nebisman/UNDCMotor/docs/WorkingDiagramMotorDC.png

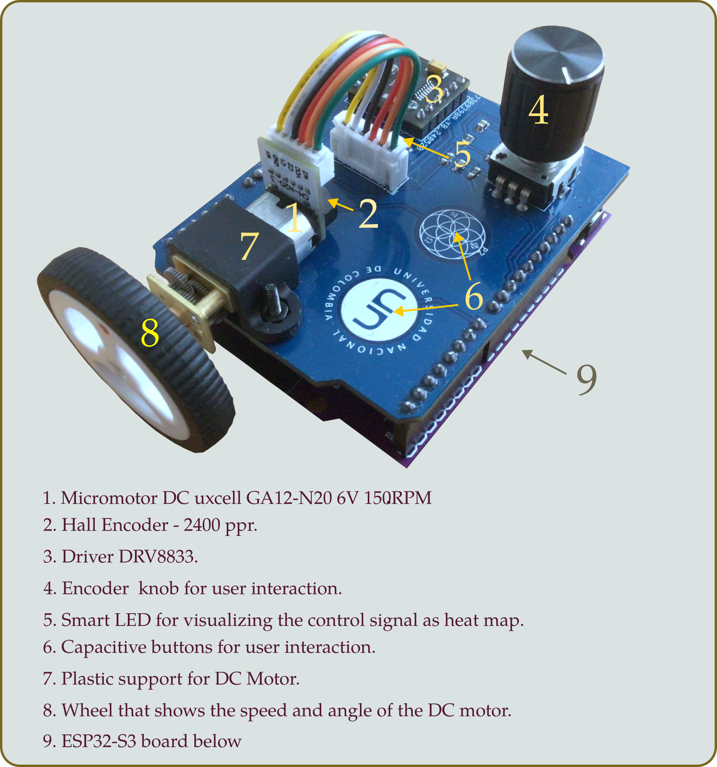
docs/WorkingDiagramMotorDC.png
