nebisman/UNDCMotor/README.md

# DCmotorSystem_IoT
This is the control of a DC motor through IoT
