nebisman/UNDCMotor/docs/modelo_matematico_unmotor.pdf

56 | Capítulo 4. Control IOT de las plantas físicas

### 4.1 Modelo matemático del UNDCMotor

| La figura 4.1 muestra el modelo electromecánico lineal de un motor DC como el usado
en el UNDCMotor. Aunque este modelo no considera efectos no lineales como la zona muerta, la fricción estática y el juego mecánico, es suficiente para el diseño de sistemas de control de movimiento [5]. Los efectos no lineales son compensados por aparte.

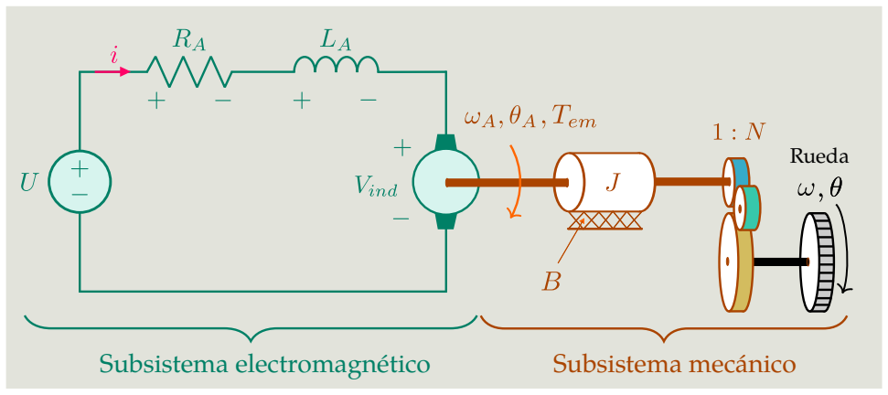
[picture p2: figure]
Subsistema electromagnético; Subsistema mecánico; Rueda

Figura 4.1: Modelo electromecánico del motor DC.

La figura 4.1 nos muestra que el motor DC puede ser descompuesto claramente en dos subsistemas: el subsistema electromagnético (verde) y el subsistema mecánico (café).

Subsistema electromagnético. Consideremos el circuito ilustrado en verde en la figura 4.1. Las variables y parámetros de este circuito se definen así:

u(t) : Tensión de entrada (V). vind(t) : Fuerza contraelectromotriz (V). i(t) : Corriente de armadura (A).
RA : Resistencia de armadura (Ω). LA : Inductancia de armadura (H).

Al aplicar la ley de tensiones de Kirchoff, obtenemos la siguiente ecuación:

u(t)−iRA −LA

di
dt
−vind(t) = 0. | (4.1)

Subsistema mecánico. Consideremos el subsistema mecánico ilustrado café en la figu-

4.1 Modelo matemático del UNDCMotor | 57

ra 4.1. Las variables y parámetros de este sistema son:

ωA : Velocidad angular del rotor (rad/s).
θA : Desplazamiento angular del rotor (rad).
ω : Velocidad angular de salida (después del reductor) (rad/s).
θ : Desplazamiento angular de salida (después del reductor) (rad). τem : Torque electromagnético generado.
J : Momento de inercia del motor (N·m).
B : Constante de fricción viscosa del motor (A).
N : Relación de engranajes del reductor (adimensional).

Al aplicar las leyes de Newton, obtenemos la siguiente ecuación:

τem −J

ωA
dt
−BωA = 0 | (4.2)

Comentario 4.1.1 — ¿Qué pasa con la inercia de la rueda?. Note que el modelo del motor DC presentado en la figura 4.1 y desarrollado en las ecuaciones
(4.1) y (4.2) asume que el momento de inercia de la rueda es despreciable. Vamos a examinar el por qué. Denotando por Mc a la masa de la rueda y por R a su radio, tenemos que el momento de inercia de la rueda está dado por:

JC =

1
2

MC R

2
. | (4.3)

Asimismo, el momento de inercia total del sistema, visto desde el rotor es:

Jeq = J +

JC
N²
. | (4.4)

La ecuación (4.3) implica que el momento de inercia Jc tiene un valor pequeño, dado que la masa Mc de la rueda es de algunos gramos. Adicionalmente, cuando
ese pequeño valor se refleja en el rotor, aparece dividido por el factor N | 2 = 10000
(véase la tabla 2.3), de acuerdo con la ecuación (4.4). De esto, concluimos que el momento de inercia de la rueda es despreciable, esto es:

Jeq ' J.

Un análisis similar nos lleva a que la fricción viscosa de la rueda también es despreciable.

Ecuaciones algebraicas: La relación entre los dominios electromagnético y mecánico está dada por la siguientes ecuaciones:

τem = µ i, | (4.5)
Vind = µ ωA, | (4.6)
ω = ωA/N. | (4.7)

58 | Capítulo 4. Control IOT de las plantas físicas

La ecuación (4.5) y la ecuación (4.6) se desprenden, respectivamente, de la ecuación de fuerza de Lorentz y de la ley de Faraday¹
. La ecuación (4.7) es la relación del reductor de engranajes del motor.

Modelo en espacio de estados: La salida de interés de nuestro sistema es la velocidad angular ω (o del dezplazamiento angular θ) después del reductor. Combinando y organizando las ecuaciones (4.1), (4.2), (4.5) y (4.6), obtenemos la siguiente representación de estado del motor DC:

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
J N −

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
u(t),

y =

h

0 1i

i

ω

+0 · u(t).

(4.8)

La descripción de estado de la ecuación (4.8) nos permite obtener la función de transferencia del motor a partir de la siguiente ecuación [4]:

G(s) = C(sI −A)

−1B+d | (4.9)

Resultado 4.1.2 — Función de transferencia del motor D.C en velocidad. Usando la ecuación (4.9) con

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
J N −

B
J N
, B =

1
LA
0
, C =

h

0 1i
, D = 0,

obtenemos la siguiente función de transferencia que relaciona la entrada U(s) (tensión en el dominio de Laplace) con Y(s) (velocidad angular en el dominio de Laplace):

Y(s)
U(s)

=

µ
J LAN s² + (BLA +J N RA) s+ µ

2 +BRA

(4.10)

En aplicaciones típicas, incluido el UNDCmotor, es usual considerar que la inductancia del susbsistema eléctrico es despreciable (esto es, LA = 0), con lo cual tendremos el siguiente modelo simplificado:

Y(s)
U(s)

=

α
τ s+1
. | (4.11)

1Para una explicación física detallada, remitimos al lector al excelente libro de Chiasson [5].

4.2 Identificación del UNDCMotor | 59

En que α y τ se definen como:

α =

µ

µ

2 +BRA

,

τ =

J N RA

µ

2 +BRA

Resultado 4.1.3 — Función de transferencia en desplazamiento angular. Deno-temos por Yθ (s) al desplazamiento angular en el dominio de Laplace. Puesto que la velocidad angular es la derivada del desplazamiento angular, tenemos que:

Y(s) = sYθ (s). | (4.12)

Substituyendo Yθ (s) de la ecuación (4.12) en la ecuación (4.10), obtenemos la función de transferencia entre la tensión y el desplazamiento angular Yθ (s):

Ω(s)
U(s)

=

µ
s( J LAN s² + (BLA +J N RA) s+ µ

2 +BRA )

. | (4.13)

Asimismo, usando la ecuación (4.11) podemos obtener una función de transferencia simplificada, dada por:
Yθ (s)
U(s)

=

α
s(τ s+1)
. | (4.14)

### 4.2 Identificación del UNDCMotor

### 4.2.1 Modelo estático

Es natural comenzar investigando el comportamiento estacionario de un sistema bajo control. Esto se hace mediante una curva que muestra el valor en estado estacionario de la salida (en este caso, la velocidad del motor DC) para diferentes valores de la variable de entrada (en este caso la tensión aplicada). A esta curva se le denomina Modelo Estático del Sistema [1].
El modelo estático se puede obtener experimentalmente de varias formas. Una manera habitual es ajustar un valor constante de entrada y medir la salida en estado estacionario. Esto da un punto del modelo estático. Este procedimiento se repite para cubrir todo el rango de entradas.
El siguiente código permite obtener directamente el modelo estático del UNDCMotor:

1 motor1 = MotorSystemIoT ()
2 get_static_model ( motor1 )

Como resultado de aplicar está función se despliega la figura 4.2.

Comentario 4.2.1 — Ganancia estática del sistema. La pendiente de la curva de la figura4.2 nos dice cuánto cambia la velocidad para pequeños cambios en la tensión de entrada. Grandes variaciones en la ganancia indican que el problema de control puede ser difícil. Por ejemplo, observamos que el UNDCMotores difícil de controlar para
