nebisman/UNDCMotor/SchematicLayout/DCmotorCircuit.kicad_pcb

## KiCad design SchematicLayout/DCmotorCircuit.kicad_pcb (2024-05-27)

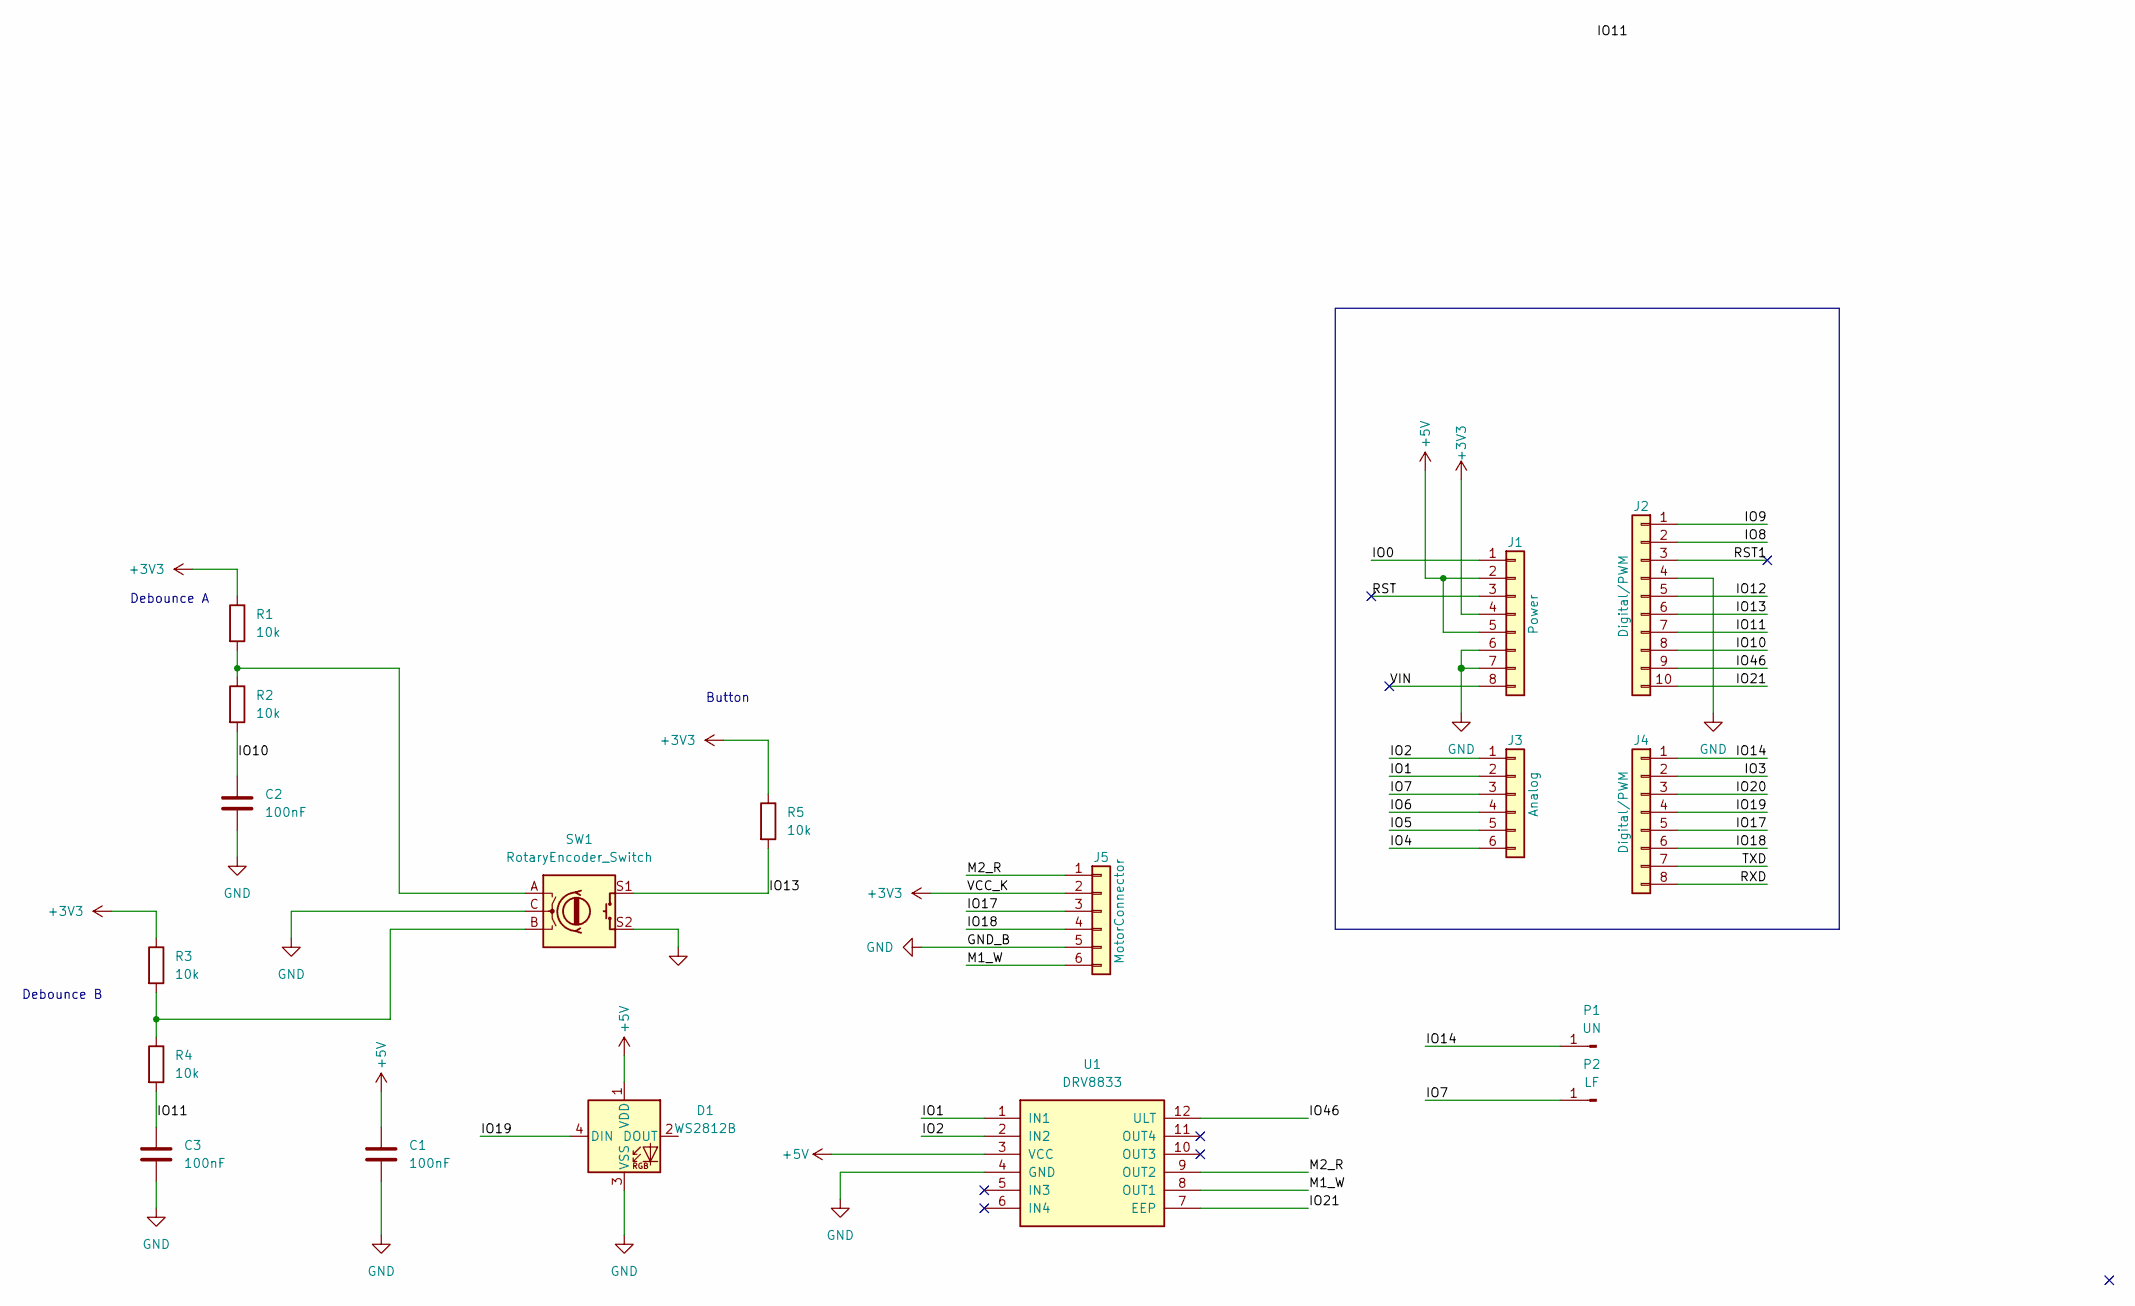
[picture p3: schematic DCmotorCircuit.kicad_sch, DC motor system for teaching control and IoT]

Parts:
C1, C2, C3: 100nF; C_0805_2012Metric_Pad1.18x1.45mm_HandSolder
D1: WS2812B; LED_SK6812MINI_PLCC4_3.5x3.5mm_P1.75mm
J1: Power; PinSocket_1x08_P2.54mm_Vertical
J2: Digital/PWM; PinSocket_1x10_P2.54mm_Vertical
J3: Analog; PinSocket_1x06_P2.54mm_Vertical
J4: Digital/PWM; PinSocket_1x08_P2.54mm_Vertical
J5: MotorConnector; JST_PH_B6B-PH-K_1x06_P2.00mm_Vertical
P1: UN; MountingHole_5mm_Pad_TopOnly
P2: LF; MountingHole_5mm_Pad_TopOnly
R1, R2, R3, R4, R5: 10k; R_0805_2012Metric_Pad1.20x1.40mm_HandSolder
SW1: RotaryEncoder_Switch; RotaryEncoder_Alps_EC11E-Switch_Vertical_H20mm
U1: DRV8833; drv8833module

Connections:
+3V3: J1.4, J5.2, R1.1, R3.1, R5.1
+5V: C1.1, D1.1 (VDD), J1.2, J1.5, U1.3 (VCC)
/IO0: J1.1
/IO1: J3.2, U1.1 (IN1)
/IO2: J3.1, U1.2 (IN2)
/IO3: J4.2
/IO4: J3.6
/IO5: J3.5
/IO6: J3.4
/IO7: J3.3, P2.1
/IO8: J2.2
/IO9: J2.1
/IO10: C2.1, J2.8, R2.2
/IO11: C3.1, J2.7, R4.2
/IO12: J2.5
/IO13: J2.6, R5.2, SW1.S1
/IO14: J4.1, P1.1
/IO17: J4.5, J5.3
/IO18: J4.6, J5.4
/IO19: D1.4 (DIN), J4.4
/IO20: J4.3
/IO21: J2.10, U1.7 (EEP)
/IO46: J2.9, U1.12 (ULT)
/M1_W: J5.6, U1.8 (OUT1)
/M2_R: J5.1, U1.9 (OUT2)
/RST: J1.3
/RST1: J2.3
/RXD: J4.8
/TXD: J4.7
/VIN: J1.8
GND: C1.2, C2.2, C3.2, D1.3 (VSS), J1.6, J1.7, J2.4, J5.5, SW1.C, SW1.S2, U1.4 (GND)
unnamed: R1.2, R2.1, SW1.A
unnamed: R3.2, R4.1, SW1.B

Notes on the sheet:
Debounce A
Button
Debounce B

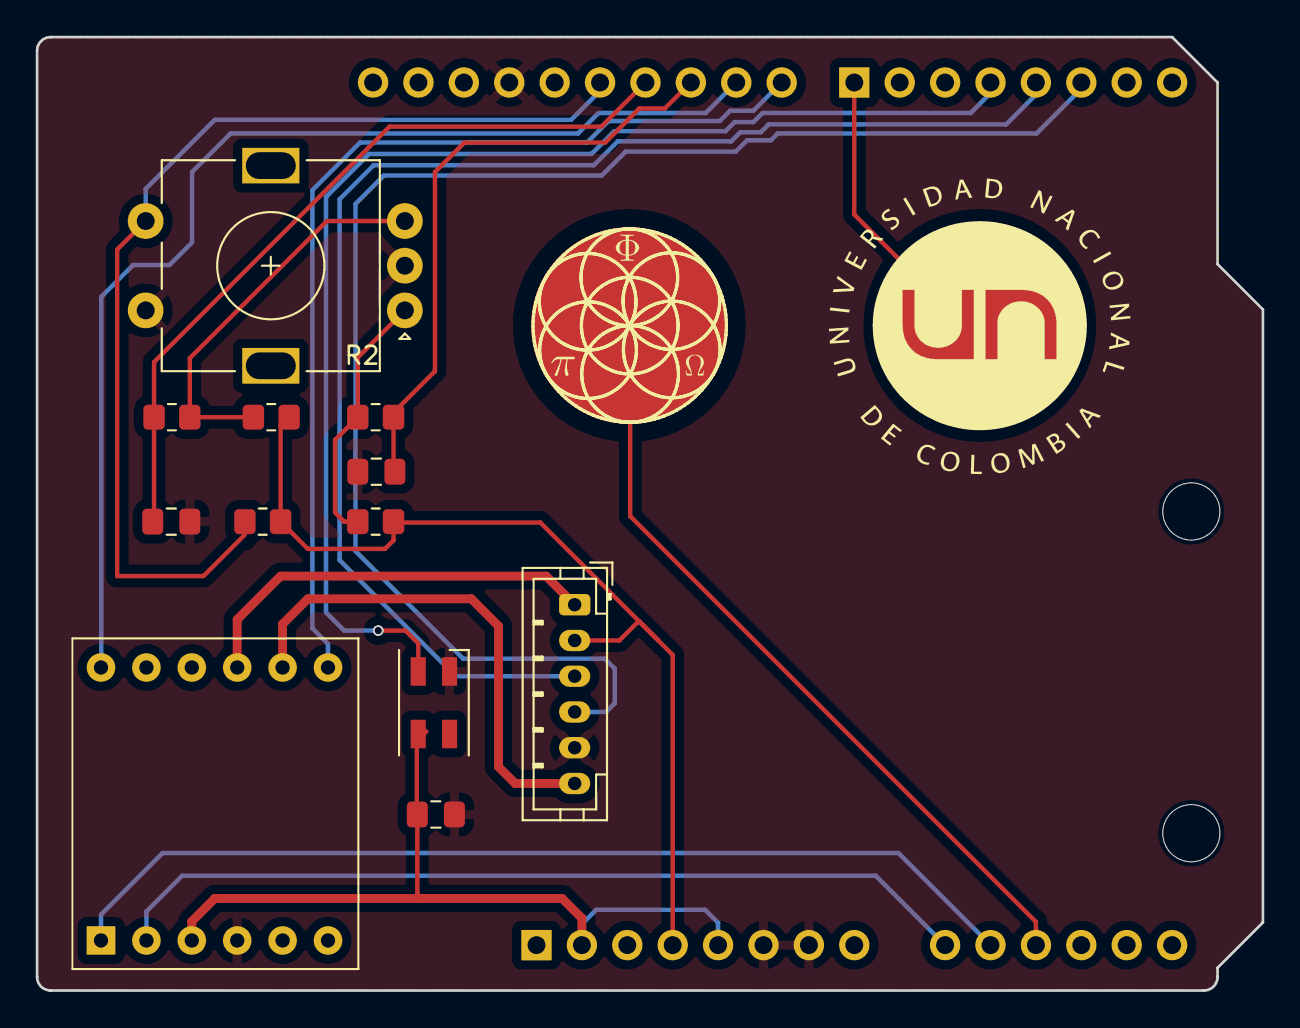
[picture p4: board DCmotorCircuit.kicad_pcb from above]

Board: 2 copper layers, 68.6 x 53.3 mm, 20 parts (0 on the bottom side), 19 nets.

Other parts of the board:
REF1, REF2: MountingHole_3.2mm
