nebisman/UNDCMotor/code/esp32_unmotor/src/connection_settings.h

// MQTT settings
#define  PLANT_NUMBER  "PC-M-10"                 // set the number of your plant
#define  THINGNAME "Motor_" PLANT_NUMBER
#define  BROKER  "192.168.1.100"         // set your broker address eg."192.168.1.100";
#define  PORT     1883                  //1883

// WiFi Network
const char WIFI_SSID[] = "lab_control";             // set your WiFi network
const char WIFI_PASSWORD[] = "lab_control";    // set the password of your WiFi network
// login access
const char USER[] = "unmotor";                // do not change
const char PASSWORD[] = "unmotor";            // do not change
