nebisman/UNDCMotor/(commit log)

2024-01-26 last version of arduinojson included
2024-02-01 the sample 0 of output has been corrected
    [dcmotor_iot.py]
2024-04-09 fir filter has been eliminated
2024-04-19 PCB files included
    [DCmotorCircuit.kicad_pcb, DCmotorCircuit.kicad_sch]
2024-05-07 controller tasks and functions updated. Now we use the kalman filter for antiwindup and change the controller realization
2024-05-27 circuit updated with analog filter for the encoder GY-40
    [DCmotorCircuit.kicad_pcb, DCmotorCircuit.kicad_sch]
2024-08-05 completing packaging
    [DCmotor_fo_model_pbrs.csv, DCmotor_fomodel_step.csv, DCmotor_prbs_open_exp.csv, DCmotor_profile_closed_exp.csv, DCmotor_so_model_pbrs.csv, DCmotor_stairs_closed_exp.csv, DCmotor_static_gain_response.csv, DCmotor_step_closed_exp.csv]
2024-08-05 try 3
    [DCmotor_prbs_open_exp.csv]
2024-08-05 all functions are working in jupyter
    [DCmotor_fo_model_pbrs.csv, DCmotor_fomodel_step.csv, DCmotor_prbs_open_exp.csv, DCmotor_profile_closed_exp.csv, DCmotor_stairs_closed_exp.csv, DCmotor_static_gain_response.csv, DCmotor_step_closed_exp.csv, DCmotor_step_open_exp.csv]
2024-08-09 firmware updated to include buttons
2024-08-10 We include parameter sync to synchronize the frames
2024-08-10 fixing the communication error when multiple requests are made.
    [esp32_unmotor.ino]
2024-08-10 printing frames
2024-08-11 printing frames and reducing qos
2024-08-11 printing frames deb
2024-08-22 updated example experiments
    [DCmotor_fomodel_step.csv, DCmotor_static_gain_response.csv, DCmotor_step_open_exp.csv]
2024-08-22 Data default experiments included in the voltage to speed and speed to voltage functions
2024-08-26 corrected version of connection of MQTT broker
    [connection_settings.h, esp32_unmotor.ino]
2024-08-27 fixed error in profile closed
    [connection_settings.h, esp32_unmotor.ino]
2024-08-28 notebook updated, eliminating broker cell and writing the current
2024-08-28 PI and PID notebook added
2024-08-31 PI and PID notebook updated and corrected
2024-09-13 Notebook for pi and pid updated and corrected
2024-09-18 Notebook for pid and pid updated
2024-09-18 Notebook pi and pid corrected
2024-10-31 anonymous access fixed in firmware
    [esp32_unmotor.ino]
